Asc91/sra-board-hardware-design/sra_dev_board_2022/sra_dev_board_2022.kicad_pcb

## KiCad design sra_dev_board_2022/sra_dev_board_2022.kicad_pcb (2022-10-26)

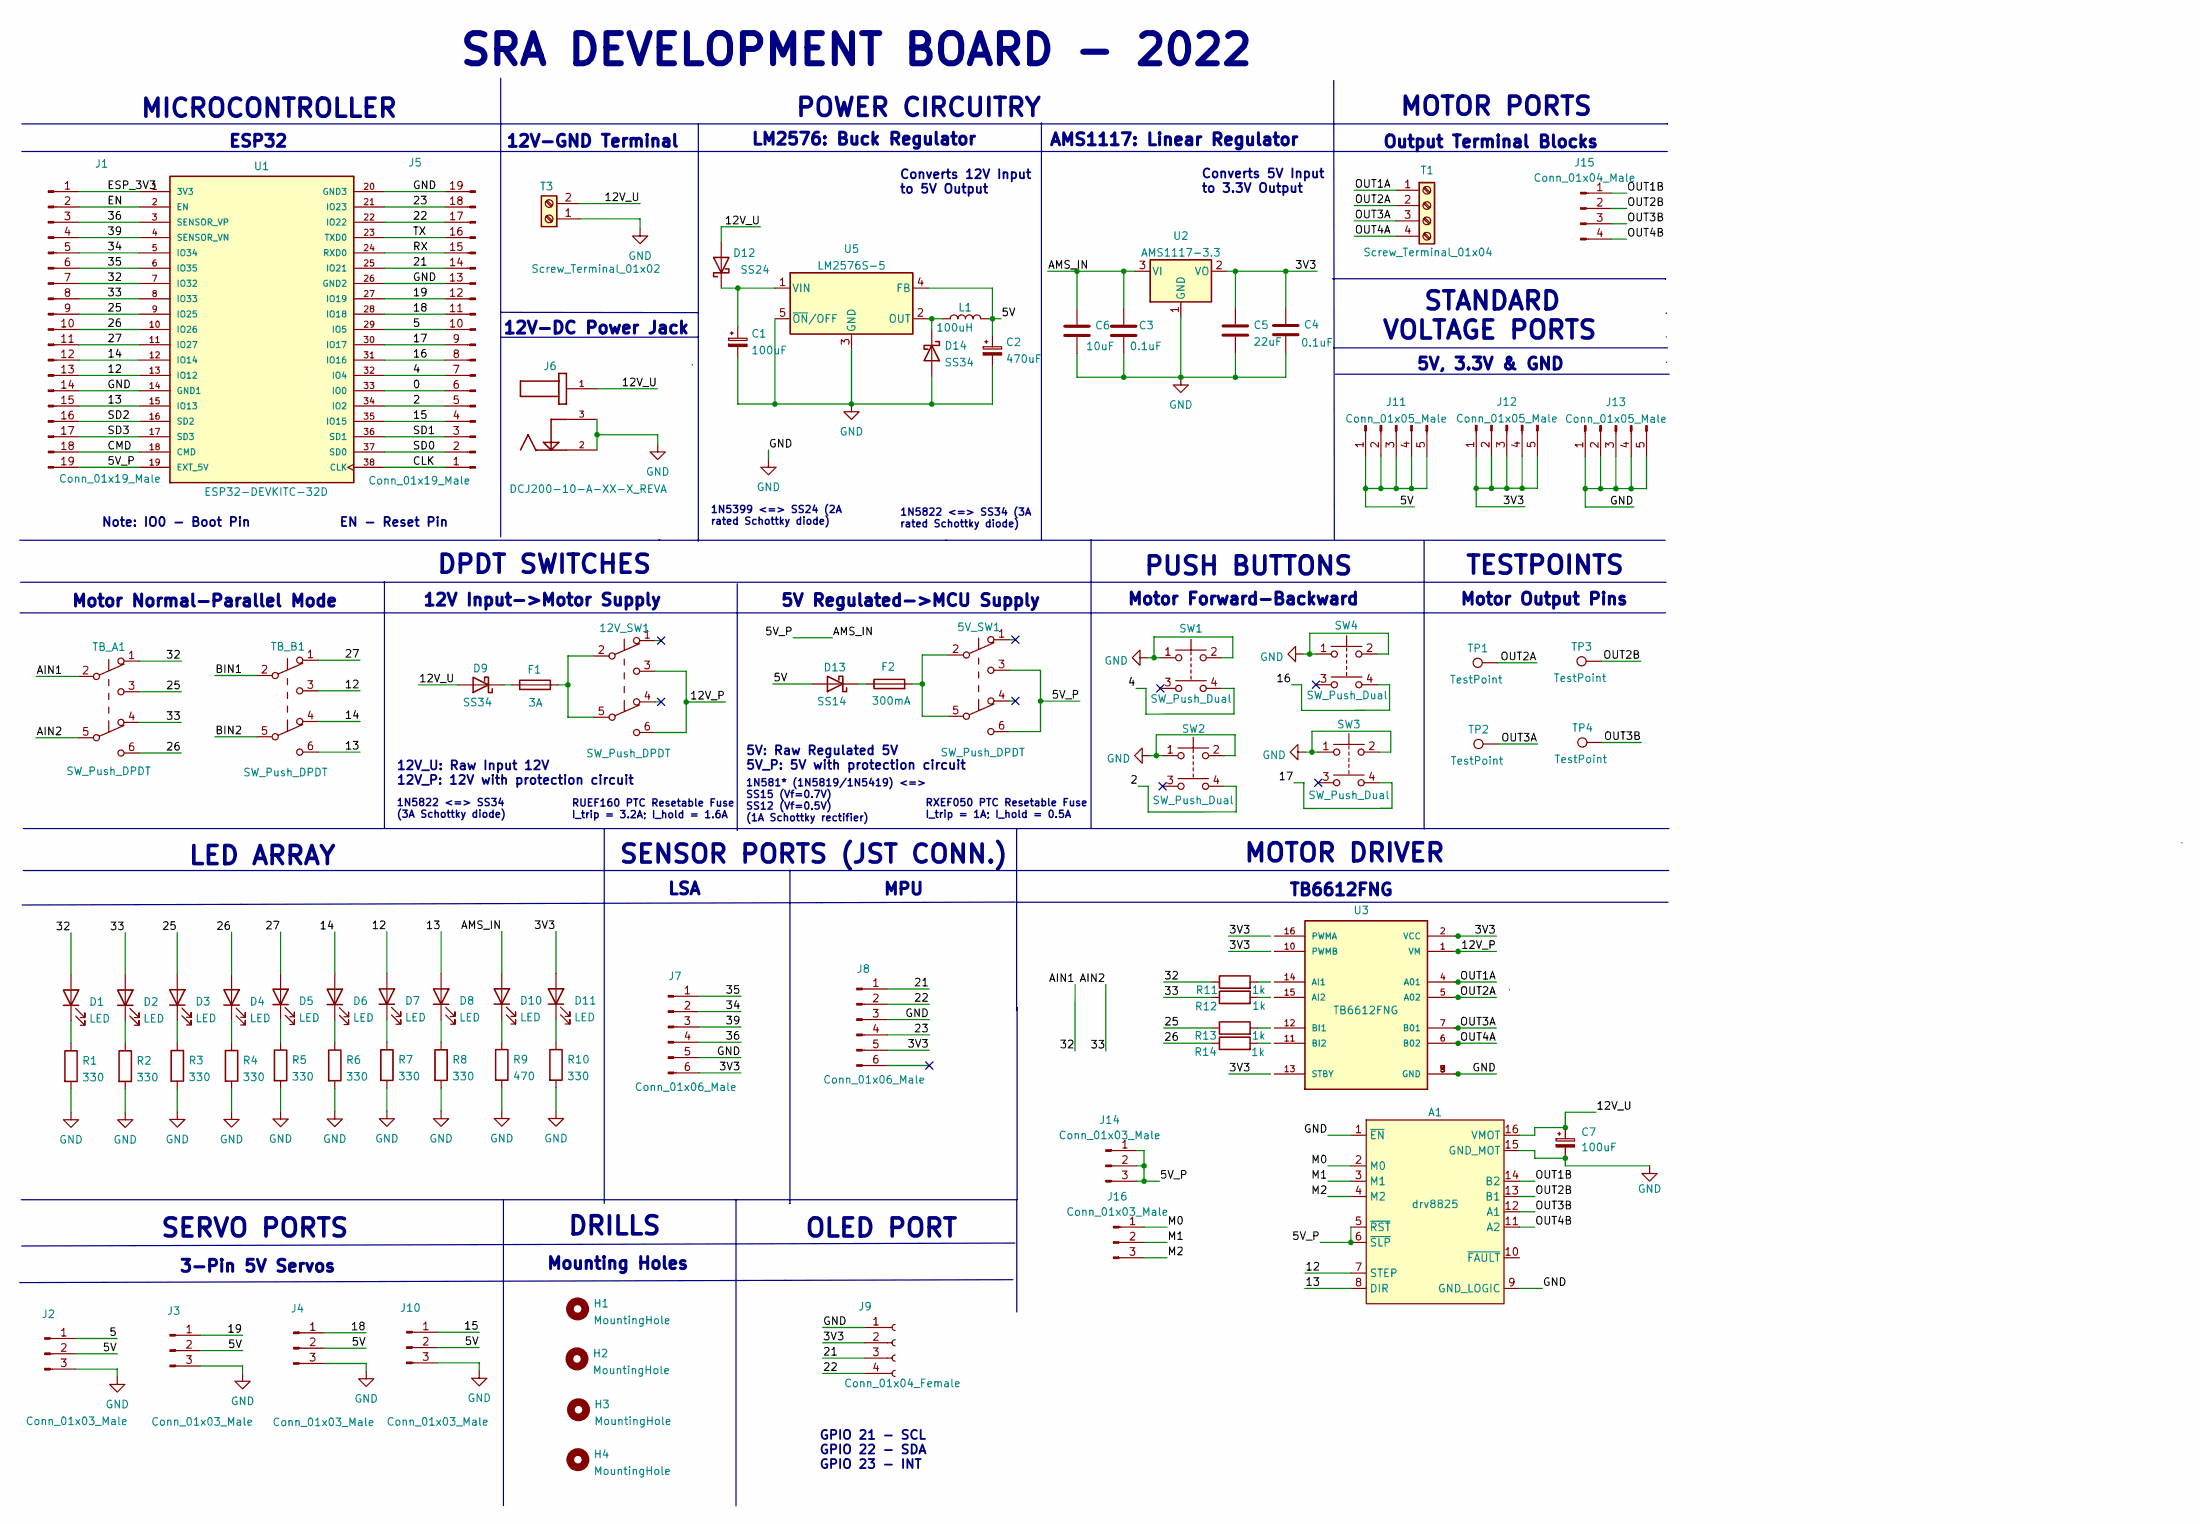
[picture p1: schematic sra_dev_board_2022.kicad_sch]

Parts:
5V_SW1, 12V_SW1: SW_Push_DPDT; dpdt_sw_2x03_tht
A1: drv8825; IC_DRV8825_STEPPER_MOTOR_DRIVER_CARRIER
C1, C7: 100uF; CP_Elec_6.3x7.7
C2: 470uF; CP_Elec_8x10
C3, C4: 0.1uF; C_0603_1608Metric
C5: 22uF; C_0603_1608Metric
C6: 10uF; C_0603_1608Metric
D1, D2, D3, D4, D5, D6, D7, D8, D10, D11: LED; LED_0603_1608Metric
D9, D14: SS34; D_SMB
D12: SS24; D_SMA
D13: SS14; D_SMA
F1: 3A; RUEF160
F2: 300mA; RXEF050
H1, H2, H3, H4: MountingHole; MountingHole_3.2mm_M3
J1, J5: Conn_01x19_Male; 1X19
J2, J3, J4, J10: Conn_01x03_Male; 1X03
J6: DCJ200-10-A-XX-X_REVA; BarrelJack_Wuerth_6941xx301002
J7, J8: Conn_01x06_Male; PinHeader_1x06_P2.54mm_Vertical
J9: Conn_01x04_Female; 1X04
J11, J12, J13: Conn_01x05_Male; 1X05
J14, J16: Conn_01x03_Male; PinHeader_1x03_P2.54mm_Vertical
J15: Conn_01x04_Male; PinHeader_1x04_P2.54mm_Vertical
L1: 100uH; CDRH127_inductor_smd
R1, R2, R3, R4, R5, R6, R7, R8, R10: 330; R_0603_1608Metric
R9: 470; R_0603_1608Metric
R11, R12, R13, R14: 1k; R_1206_3216Metric
SW1, SW2, SW3, SW4: SW_Push_Dual; spst_tactile_sw_2x02_smd
T1: Screw_Terminal_01x04; motor_1x04_tht
T3: Screw_Terminal_01x02; 12V_1x02_tht
TB_A1: SW_Push_DPDT; dpdt_sw_2x03_tht
TB_B1: SW_Push_DPDT; dpdt_sw_2x03_tht
TP1, TP2, TP3, TP4: TestPoint; pad_1,27-2,54_smd
U1: ESP32-DEVKITC-32D; ESP32-DEVKITCv4-32D; PARTREV 4
U2: AMS1117-3.3; SOT-223-3_TabPin2
U3: TB6612FNG; TB6612FNG_2; PARTREV 11-13-17
U5: LM2576S-5; TO-263-5_TabPin3

Connections:
/0: J5.6, U1.33 (IO0)
/2: J5.5, SW2.4, U1.34 (IO2)
/3V3: C4.1, C5.1, D11.2 (A), J7.6, J8.5, J9.2, J12.1, J12.2, J12.3, J12.4, J12.5, U2.2 (VO), U3.2 (VCC)
/4: J5.7, SW1.4, U1.32 (IO4)
/5: J2.1, J5.10, U1.29 (IO5)
/5V: C2.1, D13.2 (A), J2.2, J3.2, J4.2, J10.2, J11.1, J11.2, J11.3, J11.4, J11.5, L1.2, U5.4 (FB)
/5V_P: 5V_SW1.3 (C), 5V_SW1.6 (C), A1.5 (~RST), A1.6 (~SLP), C3.1, C6.1, D10.2 (A), J1.19, J14.1, J14.2, J14.3, U1.19 (EXT_5V), U2.3 (VI)
/12: A1.7 (STEP), D7.2 (A), J1.13, TB_B1.3 (C), U1.13 (IO12)
/12V_P: 12V_SW1.3 (C), 12V_SW1.6 (C), U3.1 (VM)
/12V_U: A1.16 (VMOT), C7.1, D9.2 (A), D12.2 (A), J6.1, T3.2
/13: A1.8 (DIR), D8.2 (A), J1.15, TB_B1.6 (C), U1.15 (IO13)
/14: D6.2 (A), J1.12, TB_B1.4 (A), U1.12 (IO14)
/15: J5.4, J10.1, U1.35 (IO15)
/16: J5.8, SW4.4, U1.31 (IO16)
/17: J5.9, SW3.4, U1.30 (IO17)
/18: J4.1, J5.11, U1.28 (IO18)
/19: J3.1, J5.12, U1.27 (IO19)
/21: J5.14, J8.1, J9.3, U1.25 (IO21)
/22: J5.17, J8.2, J9.4, U1.22 (IO22)
/23: J5.18, J8.4, U1.21 (IO23)
/25: D3.2 (A), J1.9, R13.1, TB_A1.3 (C), U1.9 (IO25)
/26: D4.2 (A), J1.10, R14.1, TB_A1.6 (C), U1.10 (IO26)
/27: D5.2 (A), J1.11, TB_B1.1 (A), U1.11 (IO27)
/32: D1.2 (A), J1.7, R11.1, TB_A1.1 (A), TB_A1.2 (B), U1.7 (IO32)
/33: D2.2 (A), J1.8, R12.1, TB_A1.4 (A), TB_A1.5 (B), U1.8 (IO33)
/34: J1.5, J7.2, U1.5 (IO34)
/35: J1.6, J7.1, U1.6 (IO35)
/36: J1.3, J7.4, U1.3 (SENSOR_VP)
/39: J1.4, J7.3, U1.4 (SENSOR_VN)
/BIN1: TB_B1.2 (B)
/BIN2: TB_B1.5 (B)
/CLK: J5.1, U1.38 (CLK)
/CMD: J1.18, U1.18 (CMD)
/EN: J1.2, U1.2 (EN)
/ESP_3V3: J1.1, U1.1 (3V3)
/M0: A1.2 (M0), J16.1
/M1: A1.3 (M1), J16.2
/M2: A1.4 (M2), J16.3
/OUT1A: T1.1, U3.4 (A01)
/OUT1B: A1.14 (B2), J15.1
/OUT2A: T1.2, TP1.1, U3.5 (A02)
/OUT2B: A1.13 (B1), J15.2, TP3.1
/OUT3A: T1.3, TP2.1, U3.7 (B01)
/OUT3B: A1.12 (A1), J15.3, TP4.1
/OUT4A: T1.4, U3.6 (B02)
/OUT4B: A1.11 (A2), J15.4
/RX: J5.15, U1.24 (RXD0)
/SD0: J5.2, U1.37 (SD0)
/SD1: J5.3, U1.36 (SD1)
/SD2: J1.16, U1.16 (SD2)
/SD3: J1.17, U1.17 (SD3)
/TX: J5.16, U1.23 (TXD0)
GND: A1.1 (~EN), A1.9 (GND_LOGIC), A1.15 (GND_MOT), C1.2, C2.2, C3.2, C4.2, C5.2, C6.2, C7.2, D14.2 (A), J1.14, J2.3, J3.3, J4.3, J5.13, J5.19, J6.2, J6.3, J7.5, J8.3, J9.1, J10.3, J13.1, J13.2, J13.3, J13.4, J13.5, R1.2, R2.2, R3.2, R4.2, R5.2, R6.2, R7.2, R8.2, R9.2, R10.2, SW1.1, SW1.2, SW2.1, SW2.2, SW3.1, SW3.2, SW4.1, SW4.2, T3.1, U1.14 (GND1), U1.20 (GND3), U1.26 (GND2), U2.1 (GND), U3.3 (GND), U3.8 (GND), U3.9 (GND), U5.3 (GND), U5.5 (~ON/OFF)
unnamed: 5V_SW1.2 (B), 5V_SW1.5 (B), F2.2
unnamed: 12V_SW1.2 (B), 12V_SW1.5 (B), F1.2
unnamed: C1.1, D12.1 (K), U5.1 (VIN)
unnamed: D1.1 (K), R1.1
unnamed: D2.1 (K), R2.1
unnamed: D3.1 (K), R3.1
unnamed: D4.1 (K), R4.1
unnamed: D5.1 (K), R5.1
unnamed: D6.1 (K), R6.1
unnamed: D7.1 (K), R7.1
unnamed: D8.1 (K), R8.1
unnamed: D9.1 (K), F1.1
unnamed: D10.1 (K), R9.1
unnamed: D11.1 (K), R10.1
unnamed: D13.1 (K), F2.1
unnamed: D14.1 (K), L1.1, U5.2 (OUT)

Notes on the sheet:
5V, 3.3V & GND
RXEF050 PTC Resetable Fuse I_trip = 1A; I_hold = 0.5A
Mounting Holes
SRA DEVELOPMENT BOARD - 2022
LED ARRAY
12V_U: Raw Input 12V 12V_P: 12V with protection circuit
12V-GND Terminal
1N5822 <=> SS34 (3A rated Schottky diode)
Output Terminal Blocks
LSA
MPU
Converts 5V Input to 3.3V Output
DRILLS
SENSOR PORTS (JST CONN.)
1N5399 <=> SS24 (2A rated Schottky diode)
DPDT SWITCHES
5V: Raw Regulated 5V 5V_P: 5V with protection circuit
Note: IO0 - Boot Pin EN - Reset Pin
POWER CIRCUITRY
ESP32
RUEF160 PTC Resetable Fuse I_trip = 3.2A; I_hold = 1.6A
LM2576: Buck Regulator
MICROCONTROLLER
GPIO 21 - SCL GPIO 22 - SDA GPIO 23 - INT
TB6612FNG
1N5822 <=> SS34 (3A Schottky diode)
3-Pin 5V Servos
SERVO PORTS
1N581* (1N5819/1N5419) <=> SS15 (Vf=0.7V) SS12 (Vf=0.5V) (1A Schottky rectifier)
12V Input->Motor Supply
5V Regulated->MCU Supply
OLED PORT
MOTOR PORTS
Motor Output Pins
MOTOR DRIVER
12V-DC Power Jack
Converts 12V Input to 5V Output
TESTPOINTS
PUSH BUTTONS
Motor Forward-Backward
AMS1117: Linear Regulator
STANDARD VOLTAGE PORTS
Motor Normal-Parallel Mode

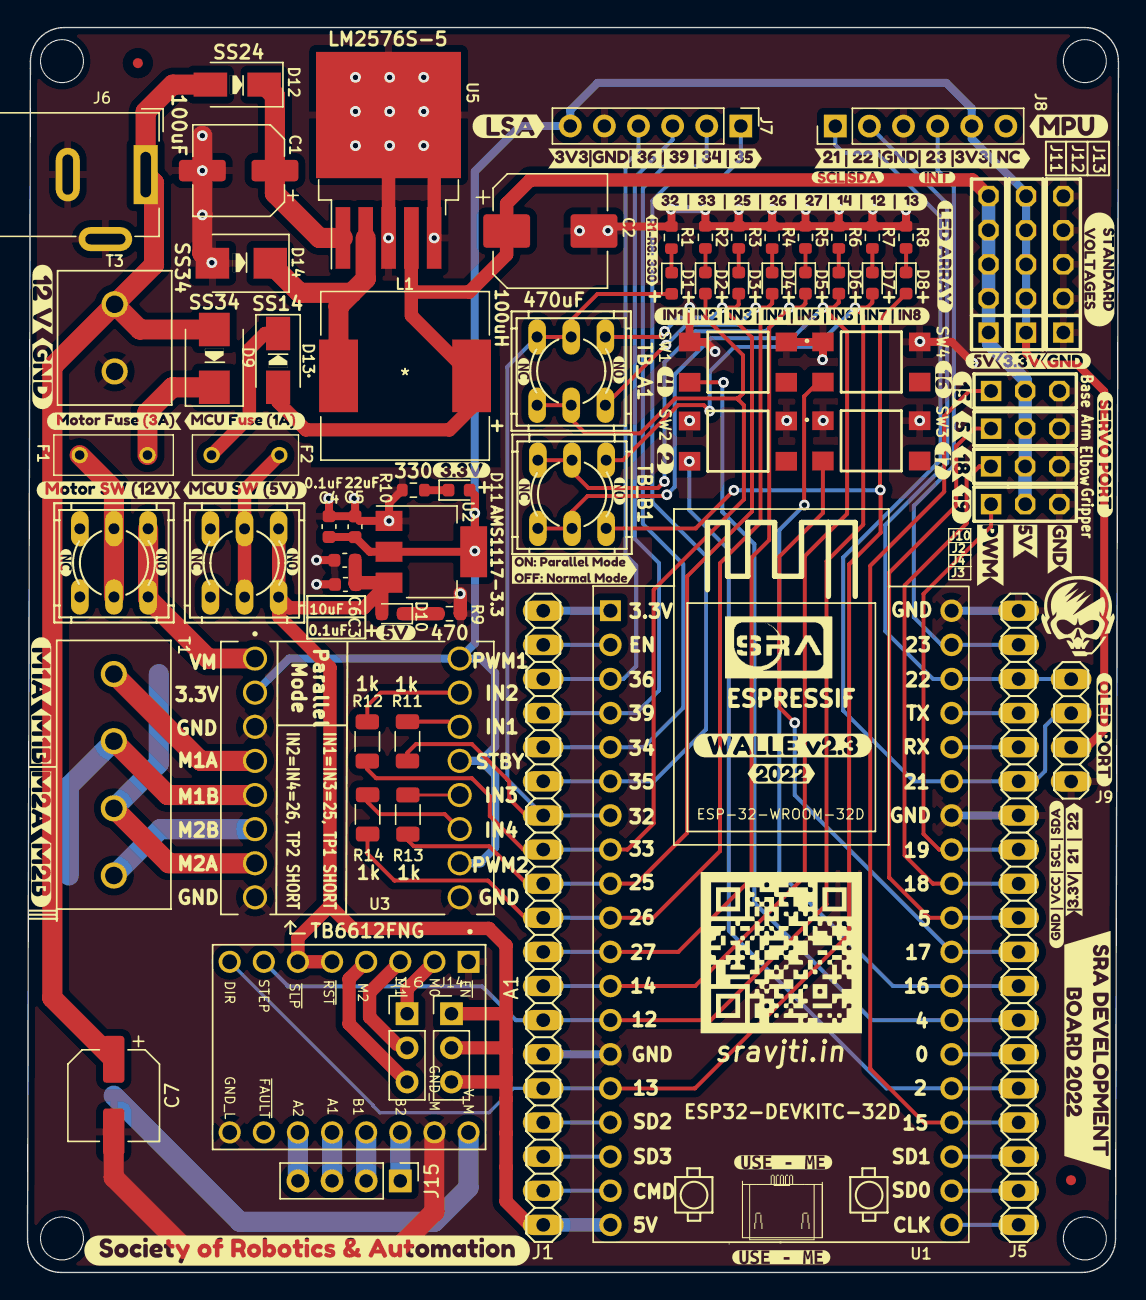
[picture p2: board sra_dev_board_2022.kicad_pcb from above]

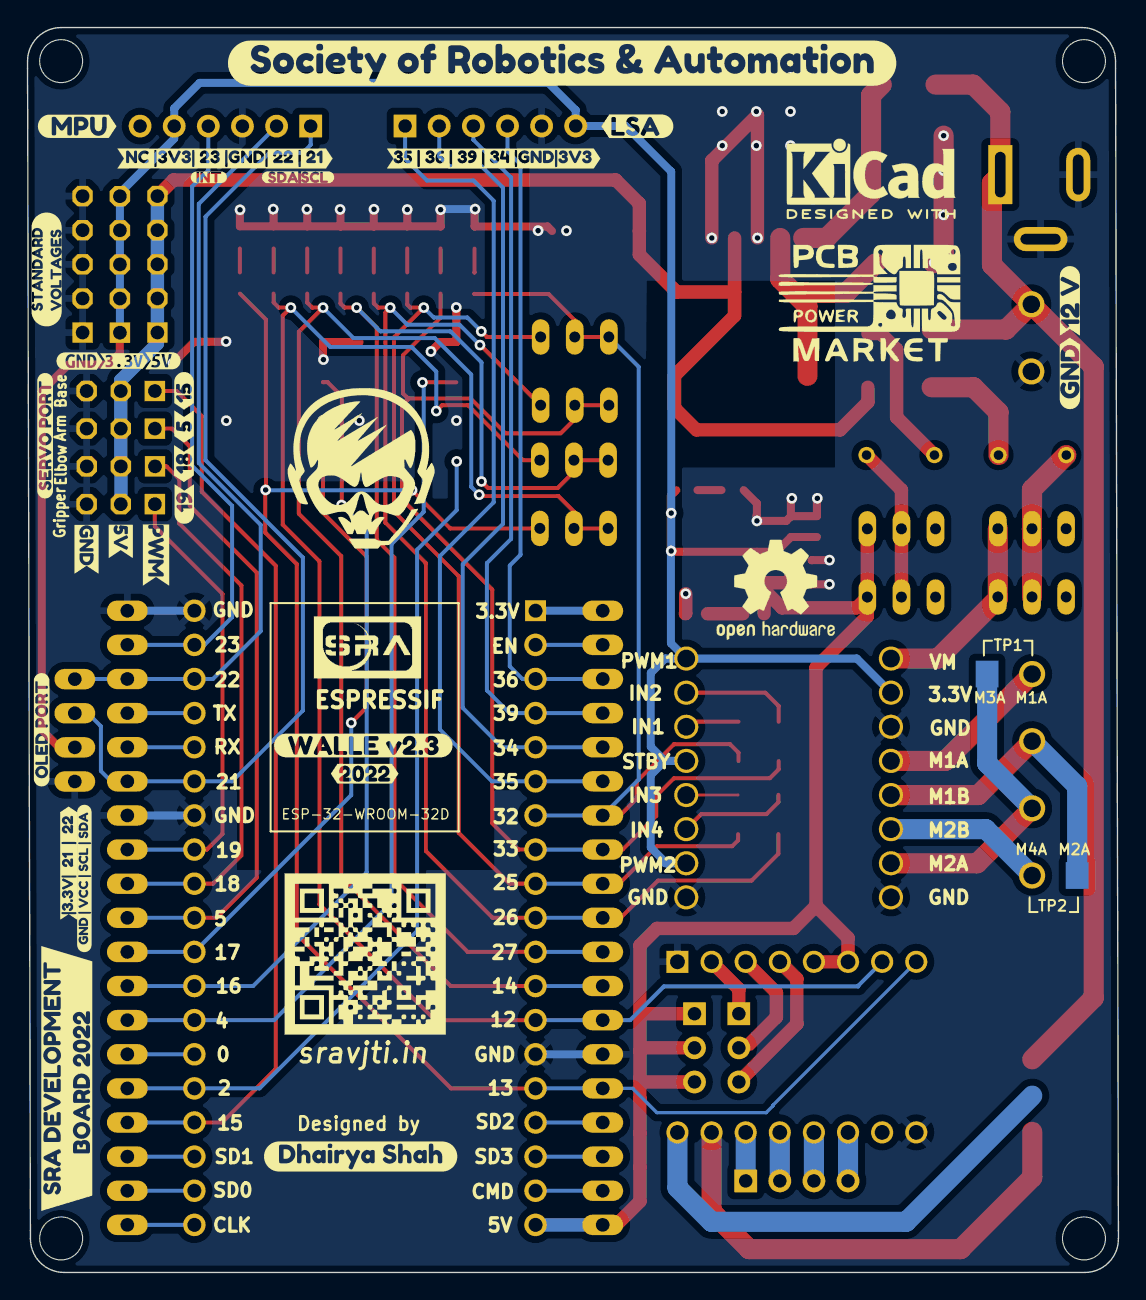
[picture p3: board sra_dev_board_2022.kicad_pcb from below]

Board: 2 copper layers, 81.2 x 92.7 mm, 165 parts (29 on the bottom side), 67 nets.

Other parts of the board:
kibuzzard-61F6A2E5, kibuzzard-61F6A2E5#2: G***; kibuzzard-61F6A2E5
kibuzzard-61F6A04D: G***; kibuzzard-61F6A04D
kibuzzard-61F6A06B: G***; kibuzzard-61F6A06B
kibuzzard-61F6A6E8, kibuzzard-61F6A6E8#2: G***; kibuzzard-61F6A6E8
kibuzzard-61F6A036: G***; kibuzzard-61F6A036
kibuzzard-61F6A088: G***; kibuzzard-61F6A088
kibuzzard-61F6A786, kibuzzard-61F6A786#2: G***; kibuzzard-61F6A786
kibuzzard-61F6ABAB, kibuzzard-61F6ABAB#2: G***; kibuzzard-61F6ABAB
kibuzzard-61F6AD1B, kibuzzard-61F6AD1B#2: G***; kibuzzard-61F6AD1B
kibuzzard-61F6AD42, kibuzzard-61F6AD42#2: G***; kibuzzard-61F6AD42
kibuzzard-61F6B85D: G***; kibuzzard-61F6B85D
kibuzzard-61F6B86D: G***; kibuzzard-61F6B86D
kibuzzard-61F6B851: G***; kibuzzard-61F6B851
kibuzzard-61F6B878: G***; kibuzzard-61F6B878
kibuzzard-61F7BB7D: G***; kibuzzard-61F7BB7D
kibuzzard-61F7C0C2: G***; kibuzzard-61F7C0C2
kibuzzard-61F7C0CC: G***; kibuzzard-61F7C0CC
kibuzzard-61F7C05B: G***; kibuzzard-61F7C05B
kibuzzard-61F7C12E: G***; kibuzzard-61F7C12E
kibuzzard-61F7C21A: G***; kibuzzard-61F7C21A
kibuzzard-61F7C24F, kibuzzard-61F7C24F#2: G***; kibuzzard-61F7C24F
kibuzzard-61F7C221: G***; kibuzzard-61F7C221
kibuzzard-61F7CB17: G***; kibuzzard-61F7CB17
kibuzzard-61F7D5C6: G***; kibuzzard-61F7D5C6
kibuzzard-61F7D60F: G***; kibuzzard-61F7D60F
kibuzzard-61F7D817: G***; kibuzzard-61F7D817
kibuzzard-61F7D852: G***; kibuzzard-61F7D852
kibuzzard-61F7E9C0: G***; kibuzzard-61F7E9C0
kibuzzard-61F7EB28: G***; kibuzzard-61F7EB28
kibuzzard-61F7EC8D: G***; kibuzzard-61F7EC8D
kibuzzard-61F7EC33: G***; kibuzzard-61F7EC33
kibuzzard-61F7EC75: G***; kibuzzard-61F7EC75
kibuzzard-61F7ED8A: G***; kibuzzard-61F7ED8A
kibuzzard-61F7ED72: G***; kibuzzard-61F7ED72
kibuzzard-61F7EDAC: G***; kibuzzard-61F7EDAC
kibuzzard-61F7EDC6: G***; kibuzzard-61F7EDC6
kibuzzard-61F7EF48: G***; kibuzzard-61F7EF48
kibuzzard-61F7EFEB: G***; kibuzzard-61F7EFEB
kibuzzard-61F7FB1D: G***; kibuzzard-61F7FB1D
kibuzzard-61F7FBA3: G***; kibuzzard-61F7FBA3
kibuzzard-61F7FBC2: G***; kibuzzard-61F7FBC2
kibuzzard-61F67ED2, kibuzzard-61F67ED2#2: G***; kibuzzard-61F67ED2
kibuzzard-61F683BD, kibuzzard-61F683BD#2, kibuzzard-61F683BD#3, kibuzzard-61F683BD#4: G***; kibuzzard-61F683BD
kibuzzard-61F712A9: G***; kibuzzard-61F712A9
kibuzzard-61F792D2, kibuzzard-61F792D2#2: G***; kibuzzard-61F792D2
kibuzzard-61F793BD: G***; kibuzzard-61F793BD
kibuzzard-61F6808A, kibuzzard-61F6808A#2: G***; kibuzzard-61F6808A
kibuzzard-61F7105E: G***; kibuzzard-61F7105E
kibuzzard-61F7127D: G***; kibuzzard-61F7127D
kibuzzard-61F7147A: G***; kibuzzard-61F7147A
kibuzzard-61F8332E: G***; kibuzzard-61F8332E
kibuzzard-61F71050: G***; kibuzzard-61F71050
kibuzzard-61F71139, kibuzzard-61F71139#2: G***; kibuzzard-61F71139
kibuzzard-61F71200: G***; kibuzzard-61F71200
kibuzzard-61F71294: G***; kibuzzard-61F71294
kibuzzard-61F71491: G***; kibuzzard-61F71491
kibuzzard-61F79319, kibuzzard-61F79319#2: G***; kibuzzard-61F79319
kibuzzard-61F82282: G***; kibuzzard-61F82282
kibuzzard-61F83333: G***; kibuzzard-61F83333
kibuzzard-620CE59A: G***; kibuzzard-620CE59A
kibuzzard-620D3ACF, kibuzzard-620D3ACF#2: G***; kibuzzard-620D3ACF
kibuzzard-620D3AFB, kibuzzard-620D3AFB#2: G***; kibuzzard-620D3AFB
kibuzzard-620D3FD3, kibuzzard-620D3FD3#2: G***; kibuzzard-620D3FD3
kibuzzard-620D3FE5: G***; kibuzzard-620D3FE5
kibuzzard-620D4F5E: G***; kibuzzard-620D4F5E
kibuzzard-620D4F84: G***; kibuzzard-620D4F84
kibuzzard-620D363E: G***; kibuzzard-620D363E
kibuzzard-620D404F: G***; kibuzzard-620D404F
kibuzzard-620D3625: G***; kibuzzard-620D3625
kibuzzard-620D3646: G***; kibuzzard-620D3646
kibuzzard-620D4024, kibuzzard-620D4024#2: G***; kibuzzard-620D4024
